maehw/diy-beatmungsgeraet/README.md

Please find detailed documentation as [README.md](./software/mass-airflow-sensor/documentation/README.md) a subfolder of this repository.
