maehw/diy-beatmungsgeraet/software/mass-airflow-sensor/documentation/images/high-level-logic-analyzer-decoder.png

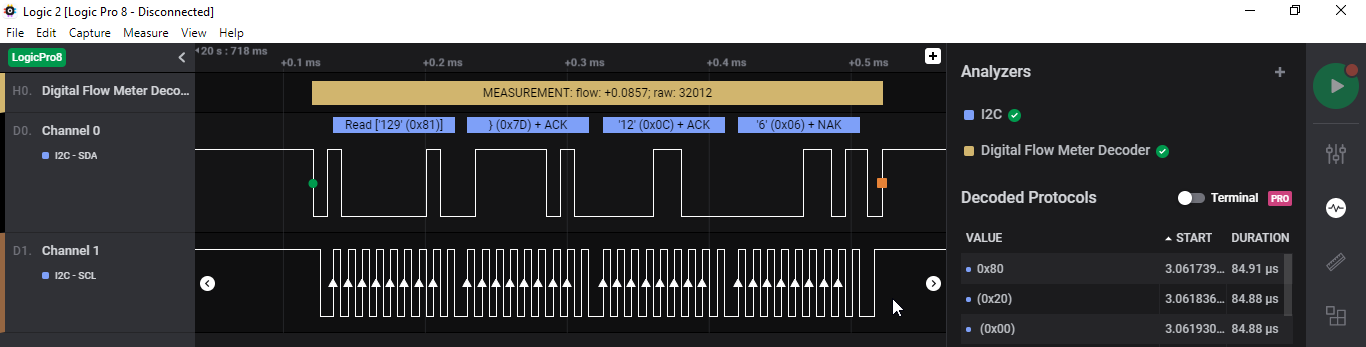
software/mass-airflow-sensor/documentation/images/high-level-logic-analyzer-decoder.png
