maehw/diy-beatmungsgeraet/software/mass-airflow-sensor/documentation/images/multiple-sensors.png

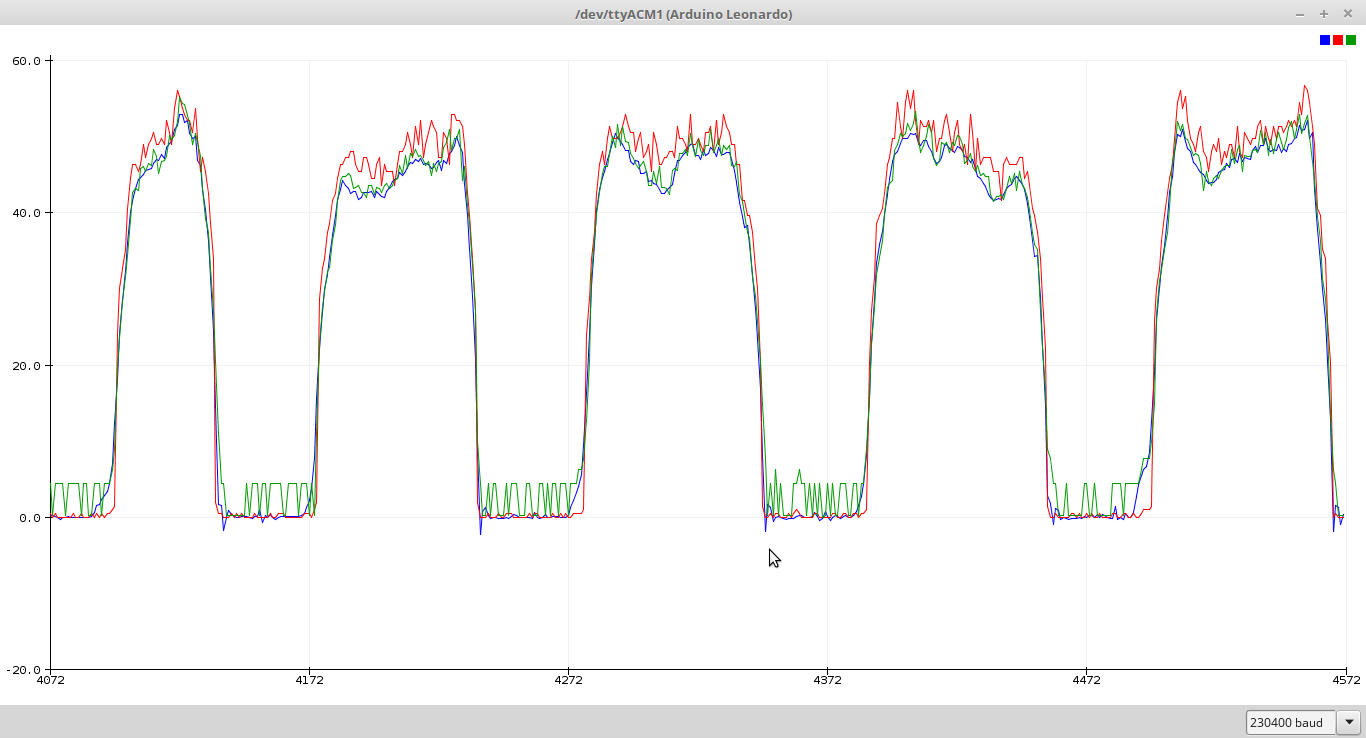
software/mass-airflow-sensor/documentation/images/multiple-sensors.png
