maehw/diy-beatmungsgeraet/hardware/mass-airflow-model/tube-grid-type_model.step

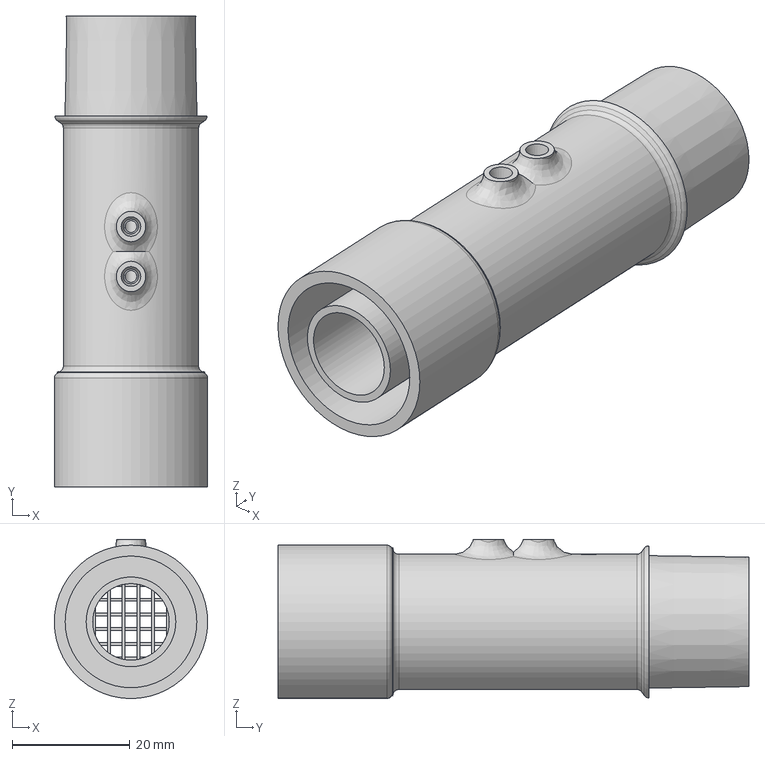
[picture p9: CAD file, 2020-04-10]
hardware/mass-airflow-model/tube-grid-type_model.step
26.1 x 80.0 x 27.0 mm
