maehw/diy-beatmungsgeraet/(list of files, cad)

Other CAD files:
hardware/mass-airflow-model/tube-grid-type_model.stl
hardware/mass-airflow-model/tube-venturi-type_model.stl
