maehw/diy-beatmungsgeraet/software/mass-airflow-sensor/documentation/images/sensor-debugging.png

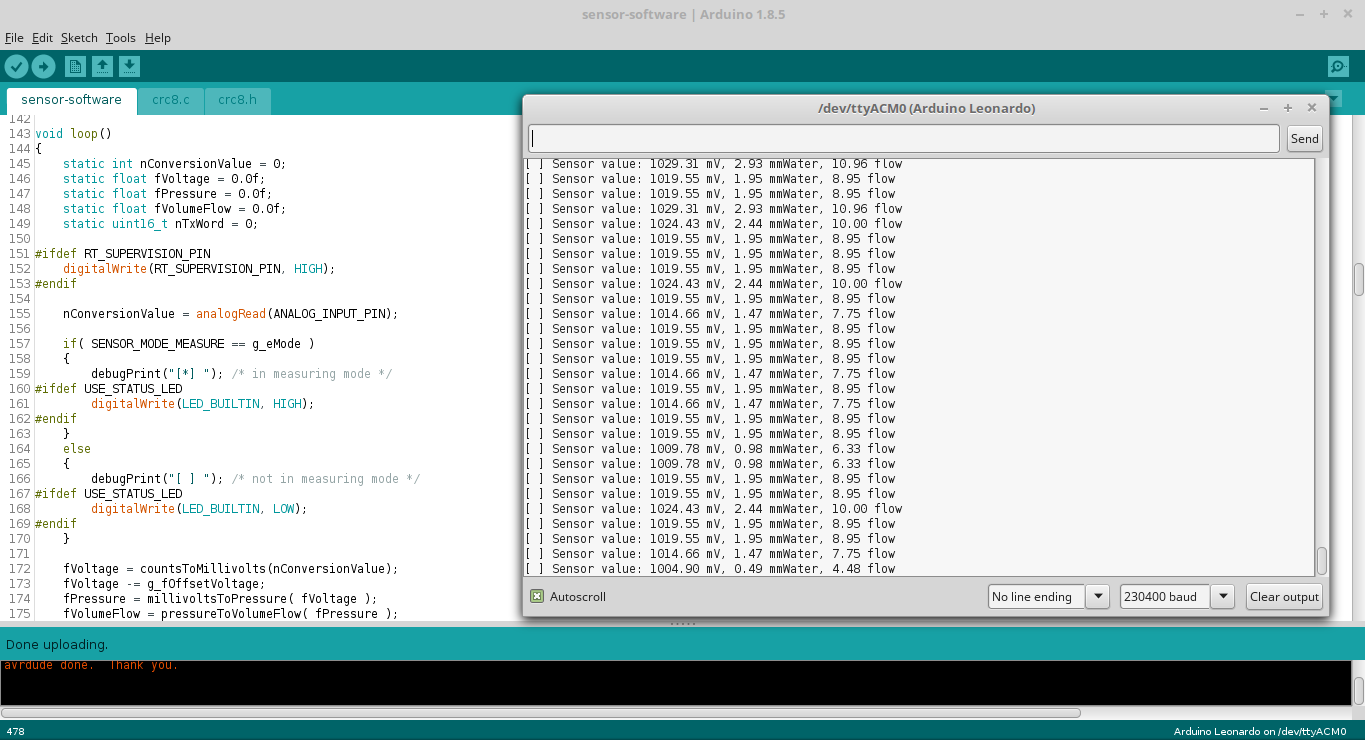
software/mass-airflow-sensor/documentation/images/sensor-debugging.png
