maehw/diy-beatmungsgeraet/hardware/mass-airflow-model/tube-venturi-type_drawing.pdf

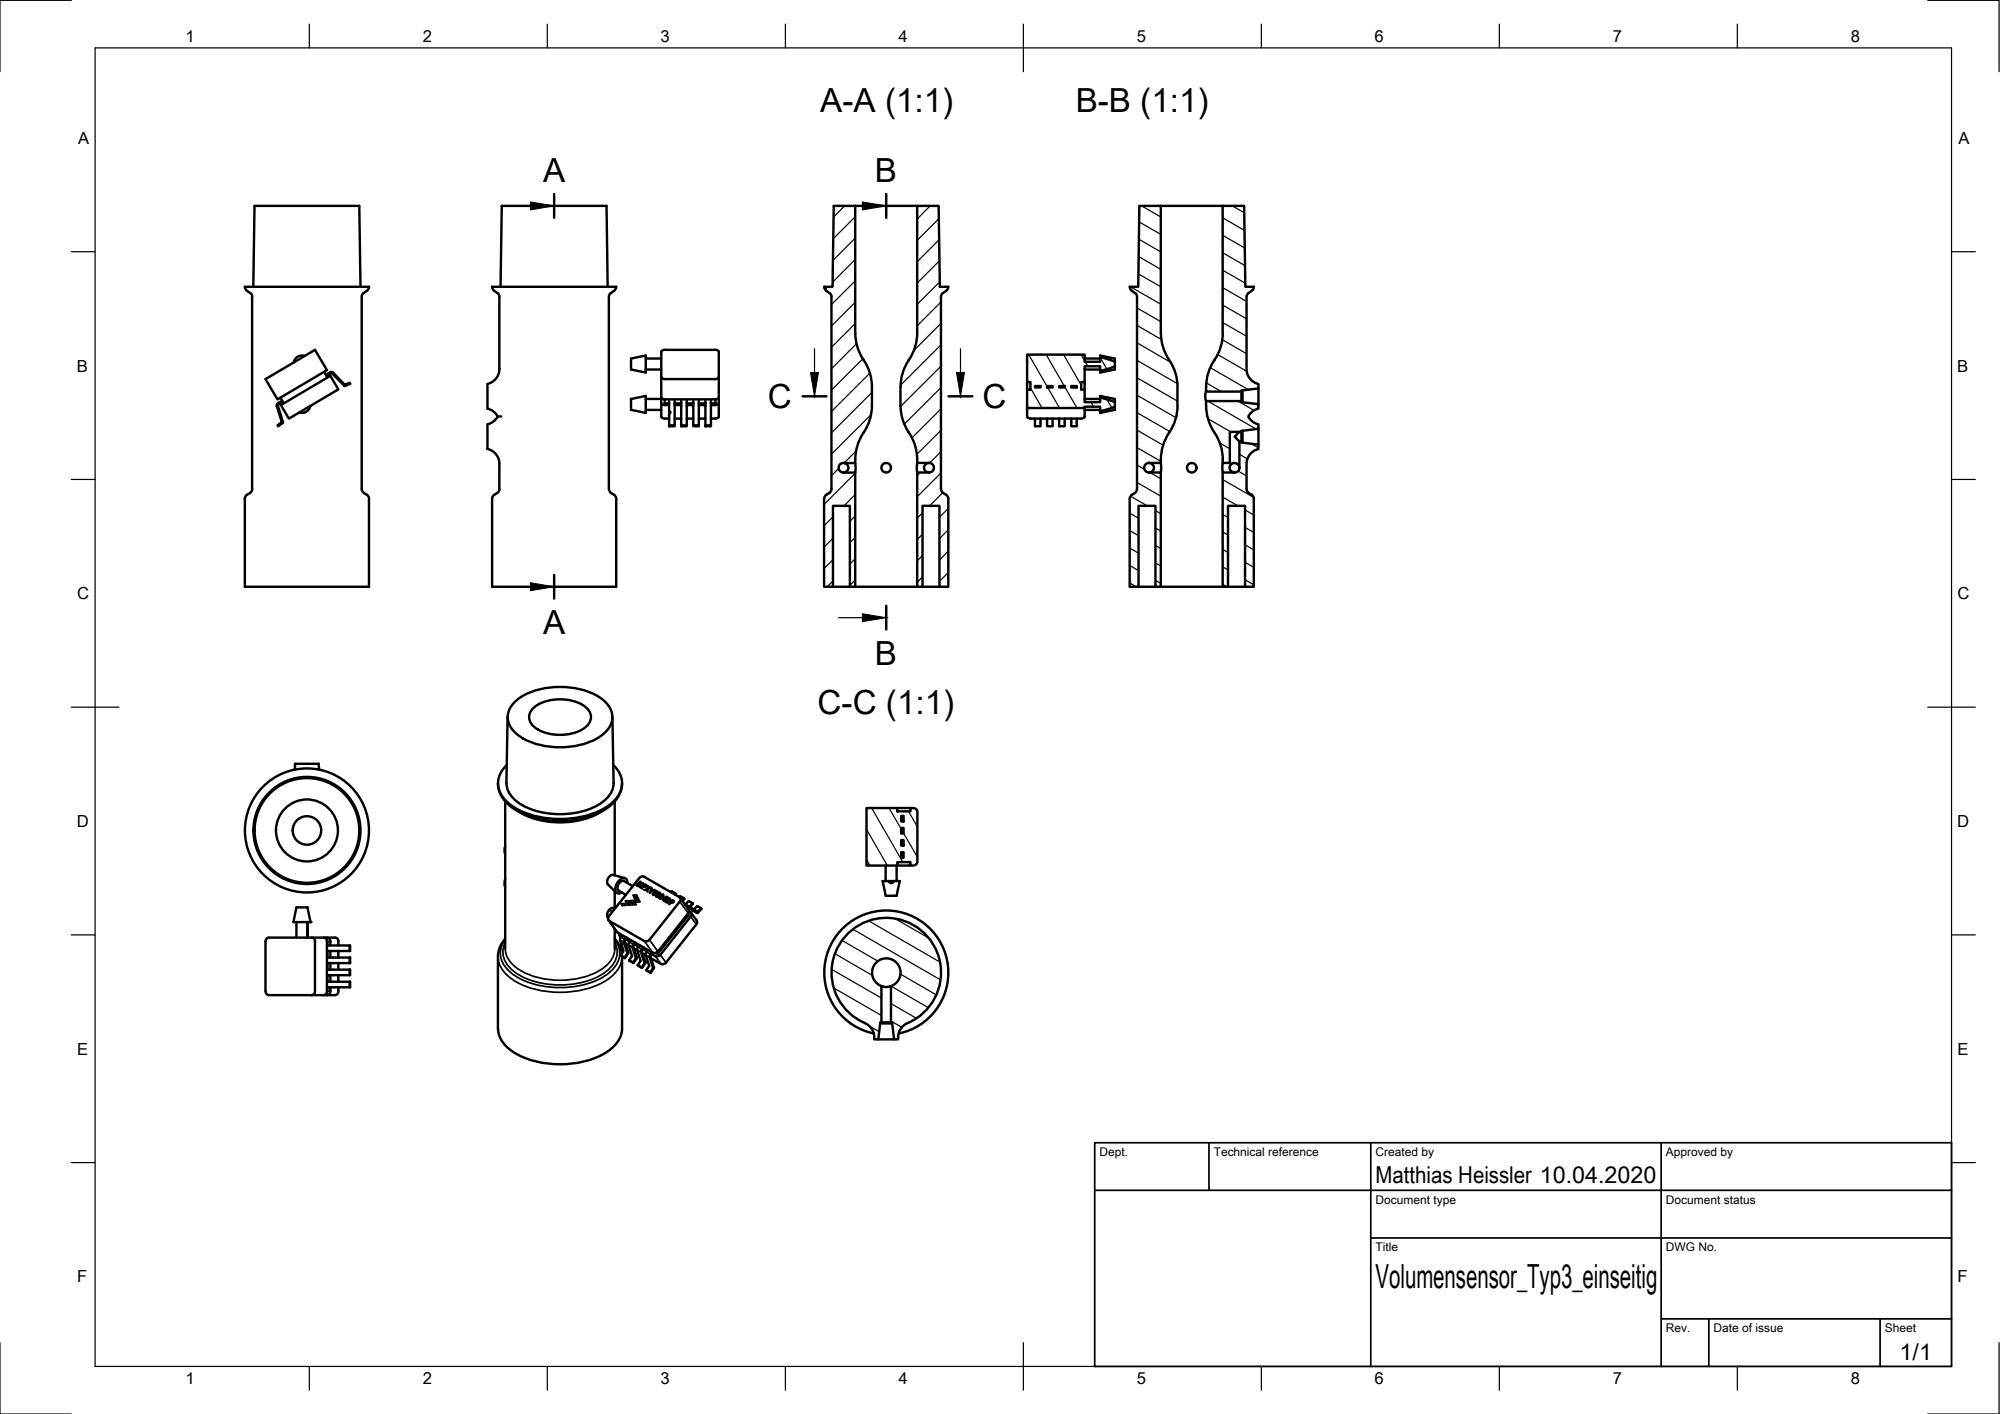
[picture p12: page 1]

Dept. | Technical reference | Created by Matthias Heissler 10.04.2020 | Approved by

Document type | Document status

Title Volumensensor_Typ3_einseitig | DWG No.

Rev. | Date of issue | Sheet 1/1
