maehw/diy-beatmungsgeraet/hardware/mass-airflow-model/tube-grid-type_drawing.pdf

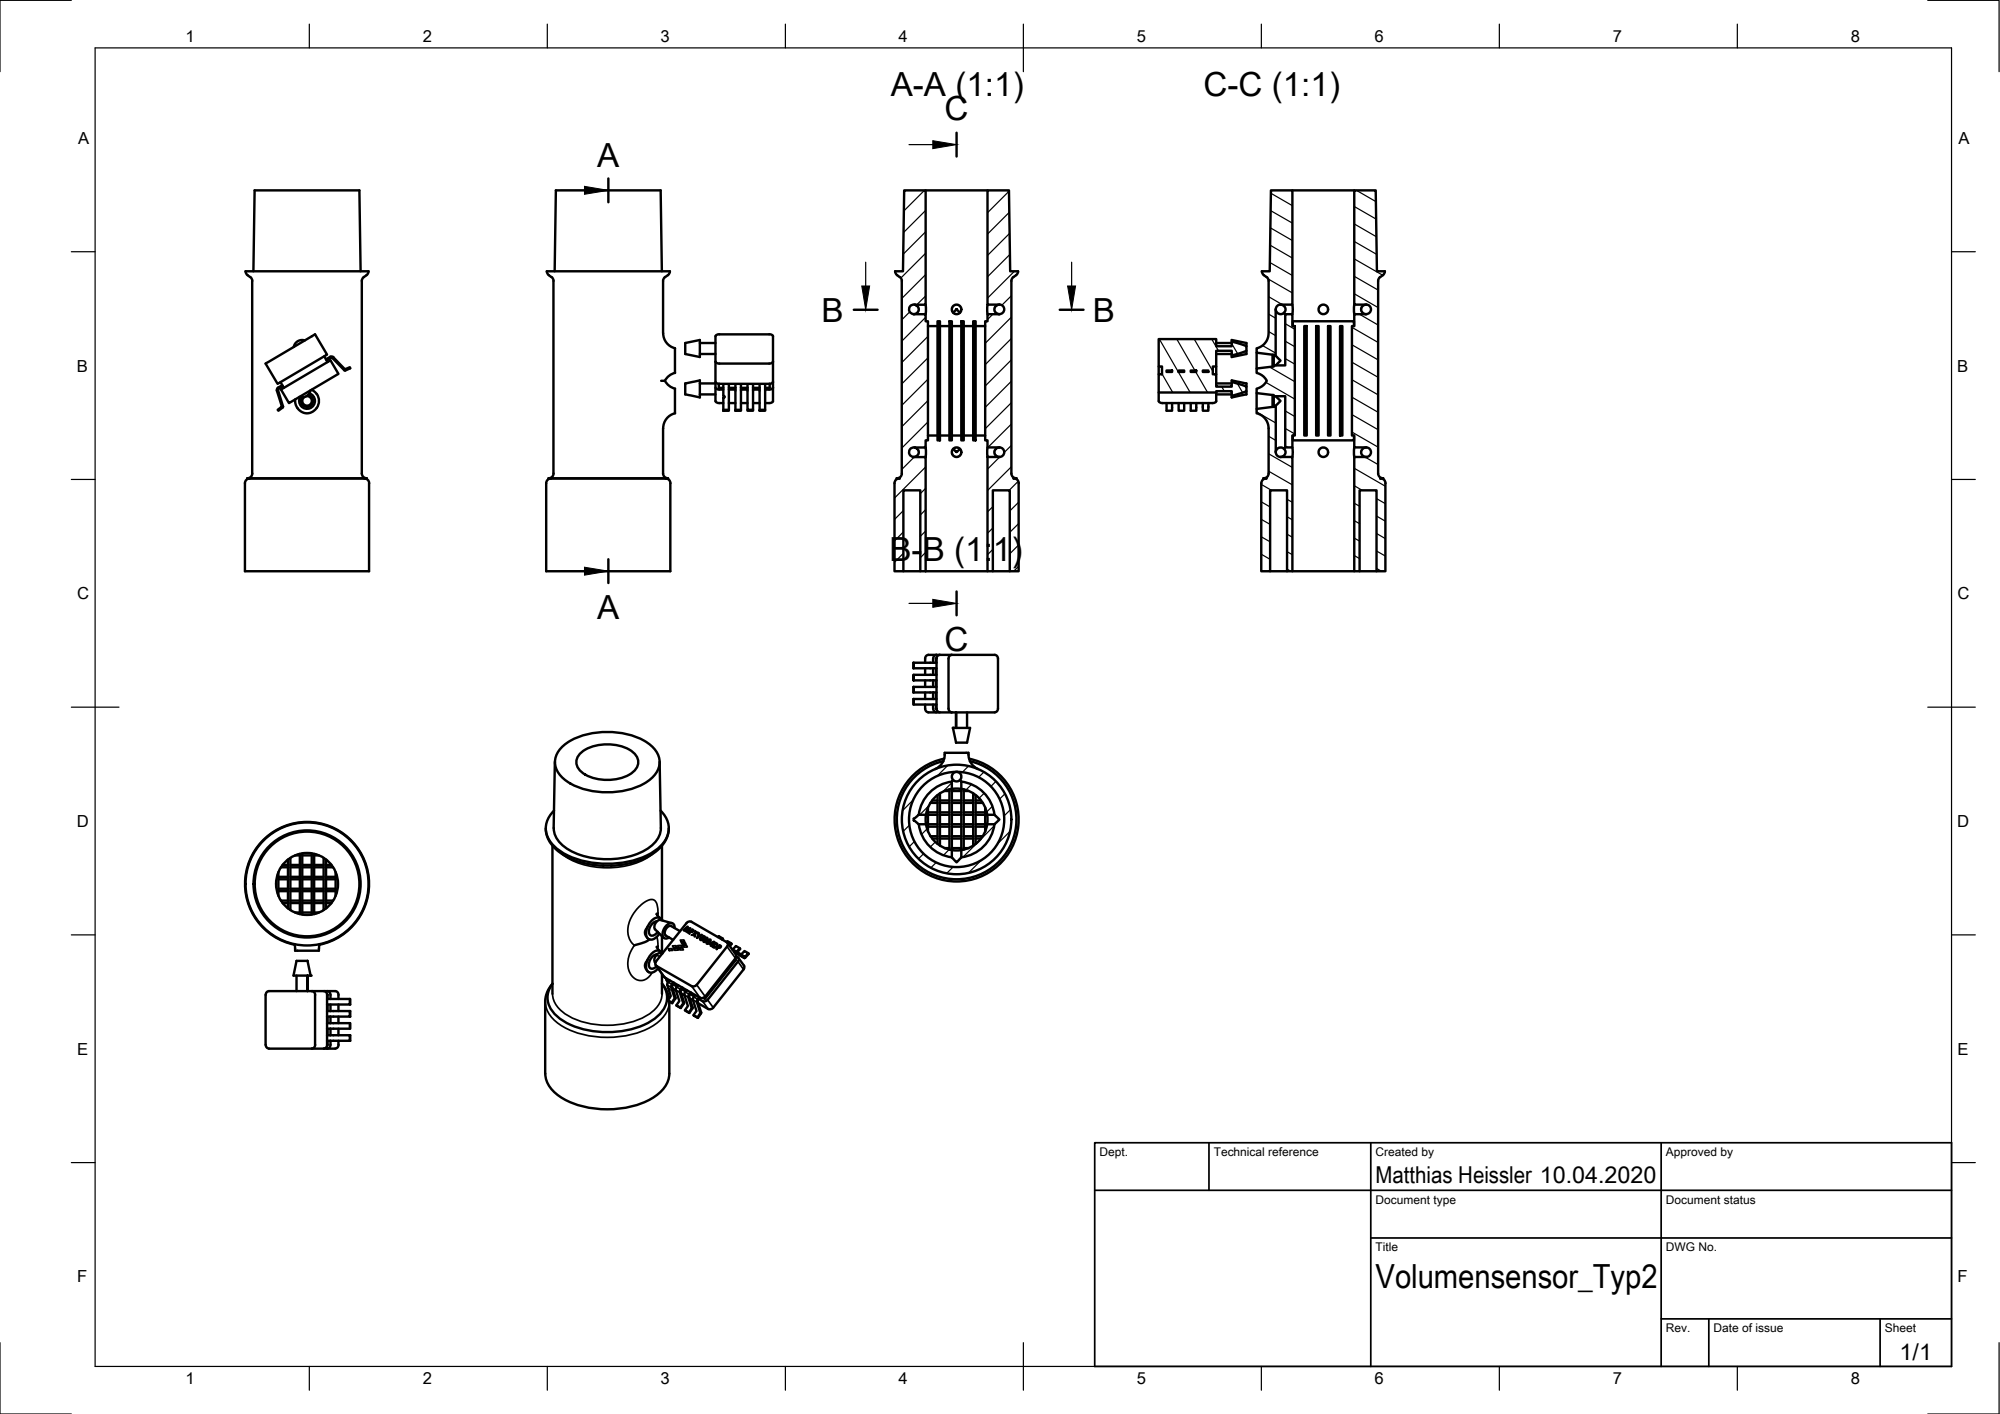
[picture p13: page 1]

Dept. | Technical reference | Created by Matthias Heissler 10.04.2020 | Approved by

Document type | Document status

Title Volumensensor_Typ2 | DWG No.

Rev. | Date of issue | Sheet 1/1
