maehw/diy-beatmungsgeraet/(list of files, drawings)

Other design files:
software/mass-airflow-sensor/documentation/flow-meter-sketch.fzz
