maehw/diy-beatmungsgeraet/(commit log)

2020-04-04 Mass airflow sensor: added short (5 tap) FIR filter + filter implementation
    [controller-software.ino]
2020-04-04 Mass airflow sensor: added inspiration/expiration detection + volume calculation
2020-04-06 Mass airflow sensor: refactored implementation to be more object-oriented, i.e. sensor class
2020-04-06 Mass airflow sensor: prepared comparison of two sensors/meters
2020-04-06 Mass airflow sensor: changed sensor to dummy values, improved controller test
2020-04-09 Mass airflow sensor: enhanced debugging of sensor software
2020-04-09 Mass airflow sensor: again changed debugging of sensor software
2020-04-09 Mass airflow sensor: changed debugging
2020-04-09 Mass airflow sensor: updated software for verification
2020-04-09 Mass airflow sensor: updated test setup for different geometry
2020-04-09 Mass airflow sensor: update debugging code
2020-04-09 Mass airflow sensor: allow negative differential pressure
2020-04-09 Mass airflow sensor: finished debugging session
2020-04-09 Mass airflow sensor: store broken configuration for later debugging
    [MassAirflowSensor.cpp, controller-software.ino, sensor-software.ino]
2020-04-10 Mass airflow sensor: moved offset voltage setting to EEPROM
2020-04-10 Mass airflow sensor: prepared controller code for multiple sensors (N > 2)
2020-04-10 Mass airflow sensor: successful test for 3 sensors
2020-04-10 Mass airflow model: added 'grid type' tube model data by @hei_matthias
    [tube-grid-type_model.stl]
2020-04-10 Mass airflow model: removed obsolete 3D model file
    [mass_airflow_tube.f3d]
2020-04-10 Mass airflow sensor: fixed EEPROM write and identifiers of NXP sensors
    [sensor-software.ino]
2020-04-10 Mass airflow model: added more model data by @hei_matthias
    [tube-grid-type_model.step, tube-venturi-type_model.step, tube-venturi-type_model.stl]
2020-04-13 Mass airflow sensor: added MATLAB/Octave code for calculation theory
2020-04-13 Mass airflow sensor: added draft of Logic2 high level analyzer/decoder for I2C protocol
2020-04-14 Mass airflow sensor decoder/analyzer: improved Python decoder/analyzer
2020-04-14 Mass airflow sensor decoder/analyzer: added Saleae Logic2 recording
2020-04-14 Mass airflow sensor: added soft reset command in controller and more debugging options
    [MassAirflowSensor.cpp, MassAirflowSensor.h]
2020-04-14 Mass airflow sensor: added soft reset command to the controller code
    [controller-software.ino]
2020-04-14 Mass airflow sensor: prepared controller code for different flow meter
2020-04-18 Add documentation for hardware setup (Fritzing sketch and screenshot)
    [flow-meter-sketch.fzz]
2020-04-18 Moved flow meter Fritzing sketch and screenshot
    [flow-meter-sketch.fzz]
2020-04-18 Updated docu with DIY mass air flow meter
2020-04-18 Added brief documentation for sensor code
2020-04-18 Improved documentation of 3D tube models
2020-04-19 Fixed bug in venturi flow calculation
2020-04-19 Updated documentation for flow calculation/estimation
2020-04-19 Replaced LaTeX-style formulas by images (docu of flow calculation/estimation)
2020-04-19 Update of HLA for sensor protocol (without the logging option)
2020-04-19 Updated sensor software + its docu
2020-04-19 Improved mass air flow sensor class and controller init sequence
2020-04-25 Improved sensor code and documentation
2020-04-26 Sensor core: changed debug output; prepared sensor for additional raw output
2020-04-29 Sensor code: Updated docu with table of commands and readout messages
2020-04-29 Sensor code: renamed command enum
2020-04-29 Mass air flow sensor: updated MassAirflowSensor class - prepared for debugging commands
2020-04-29 Sensor & controller code: prepared debugging/verification modes with raw data trx
2020-04-29 Sensor software: removed support for Grid type geometry
2020-04-29 Updated docu, sensor and controller software to prepare verification
2020-05-26 Uploaded experimental design made in OpenSCAD
    [venturi-openscad-experimental.scad]
